bartex00001/The-Keyboard-Project/README.md

# The Keyboard Project  

Documentation can be found here:  
[Notion - The Keyboard Project](https://stefbart.notion.site/The-Keyboard-Project-20efdf3d025f40b1b14f3d861e6cc41f)
