bartex00001/The-Keyboard-Project/Design/Keyboard_layout/23-lines.png

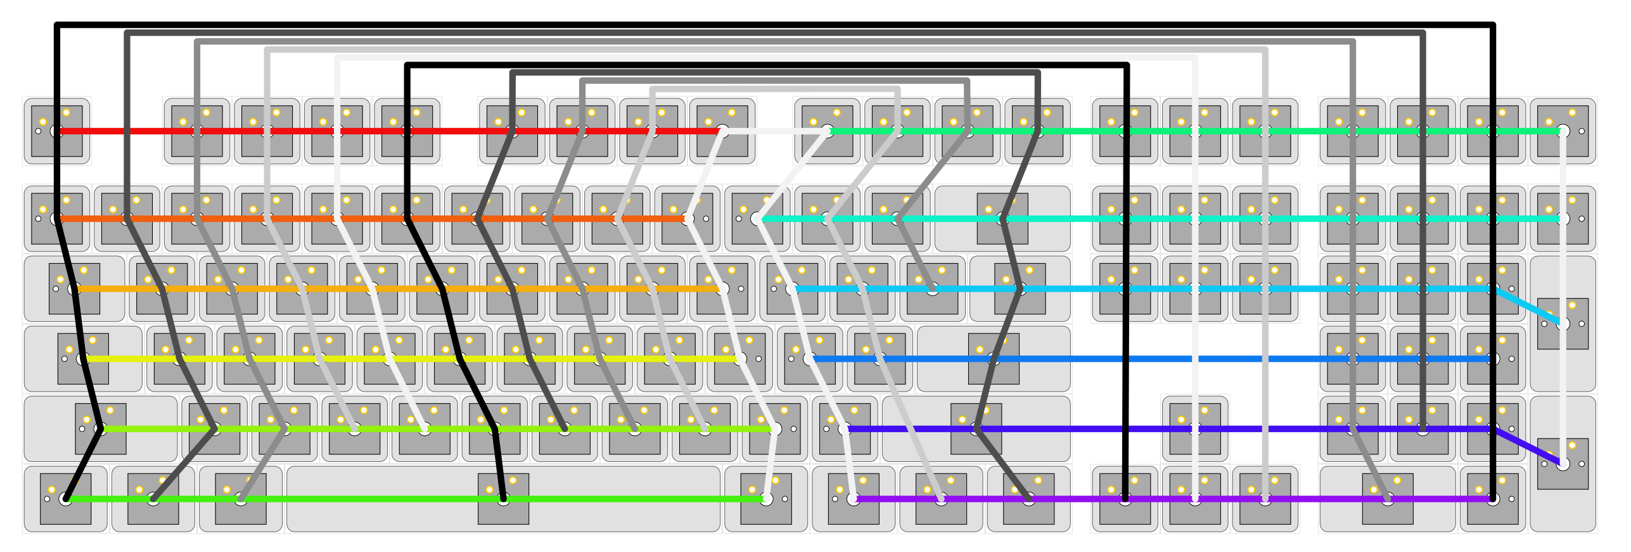
Design/Keyboard_layout/23-lines.png
