bartex00001/The-Keyboard-Project/Design/Keyboard_layout/The keyboard layout.png

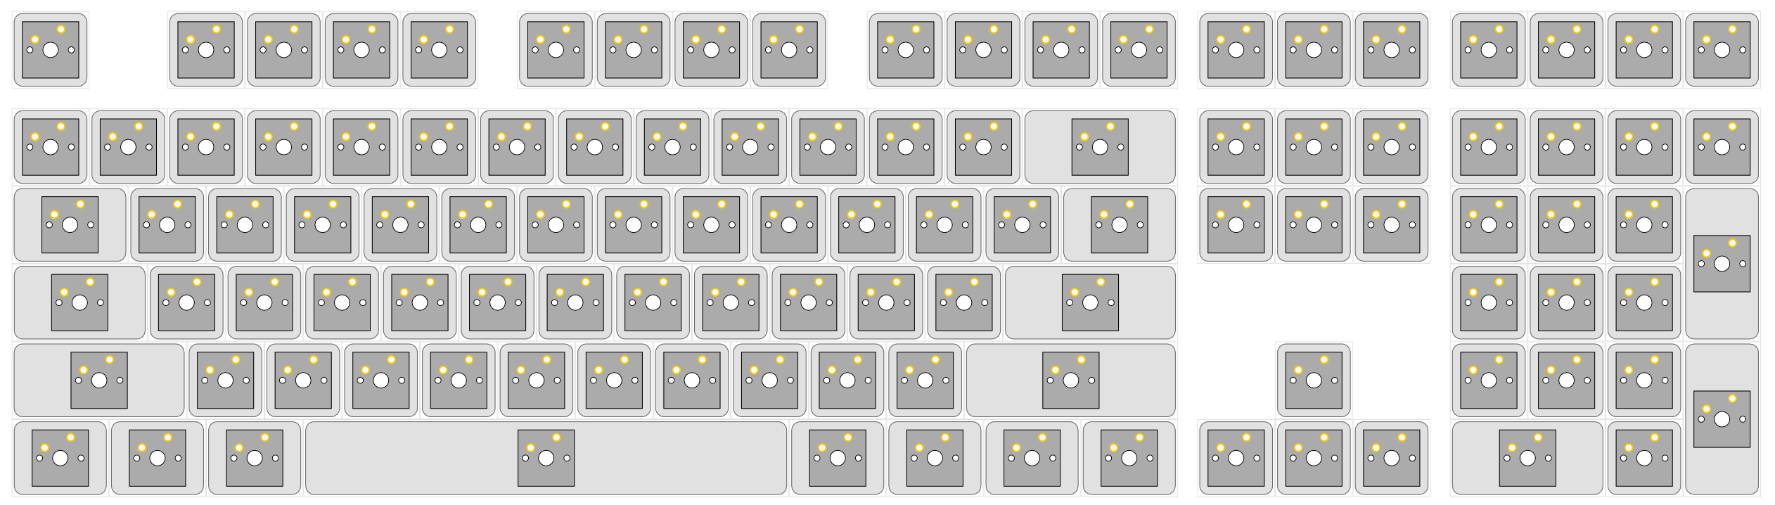
Design/Keyboard_layout/The keyboard layout.png
