bartex00001/The-Keyboard-Project/PCB/main_board/Crystal.png

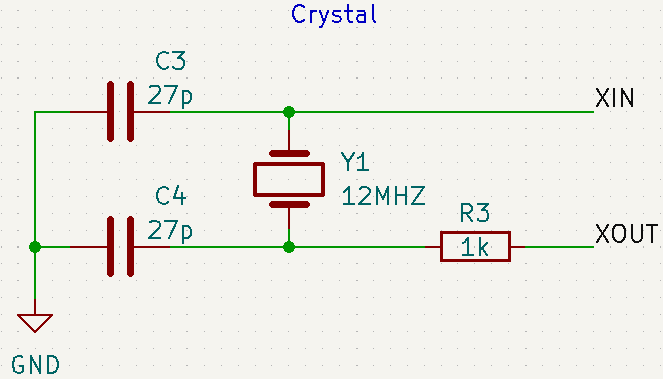
PCB/main_board/Crystal.png
