bartex00001/The-Keyboard-Project/PCB/main_board/Flash memory.png

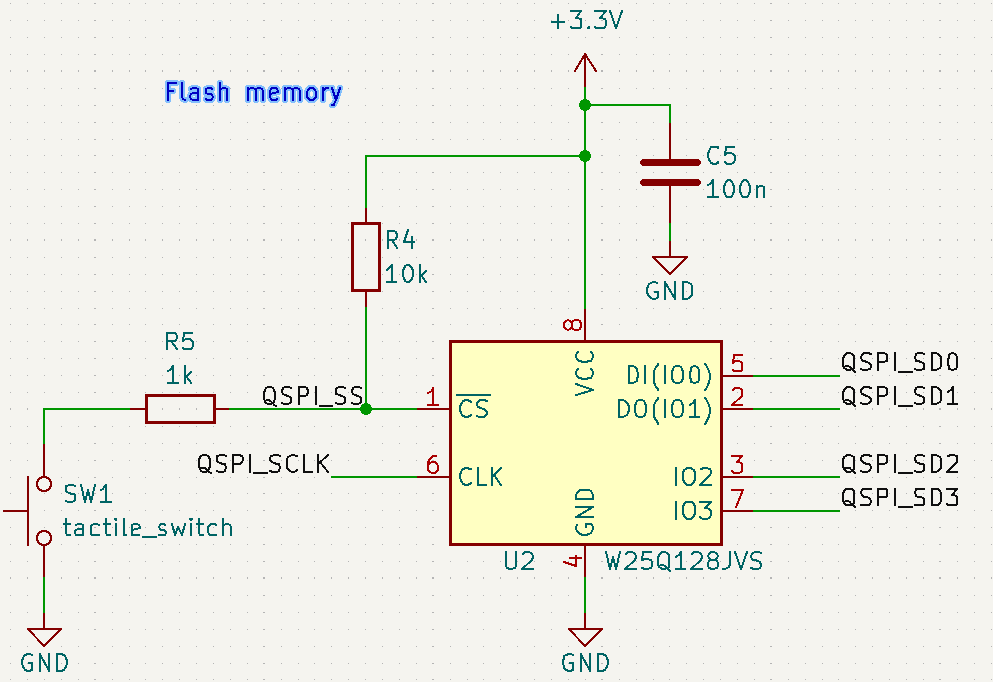
PCB/main_board/Flash memory.png
