bartex00001/The-Keyboard-Project/PCB/main_board/Key matrix.png

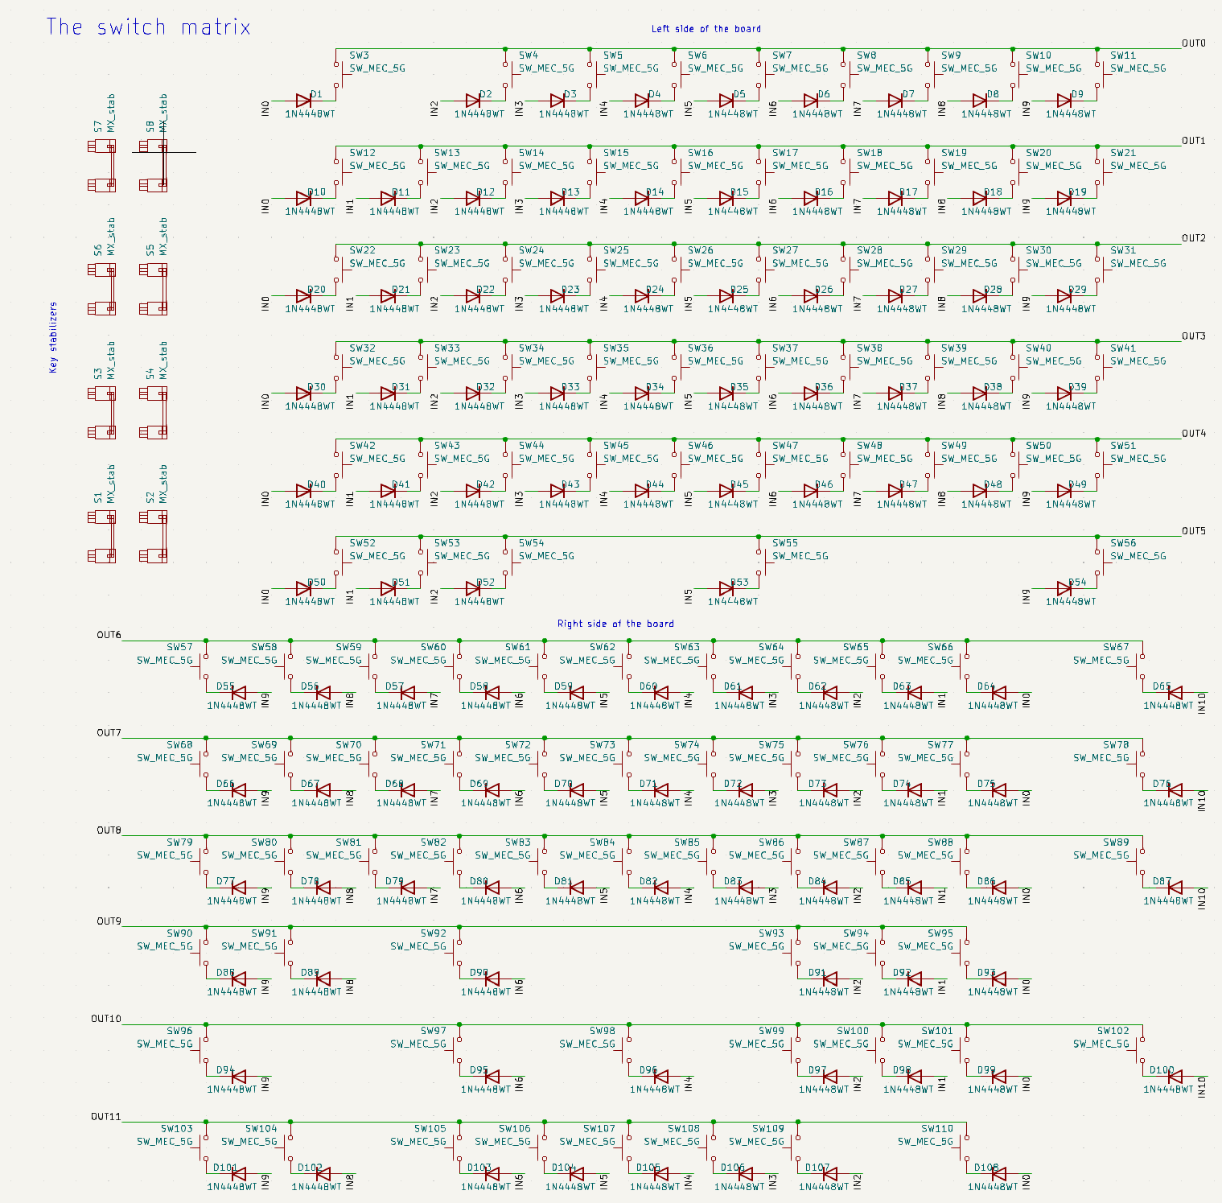
PCB/main_board/Key matrix.png
