bartex00001/The-Keyboard-Project/PCB/main_board/Power supply & usb.png

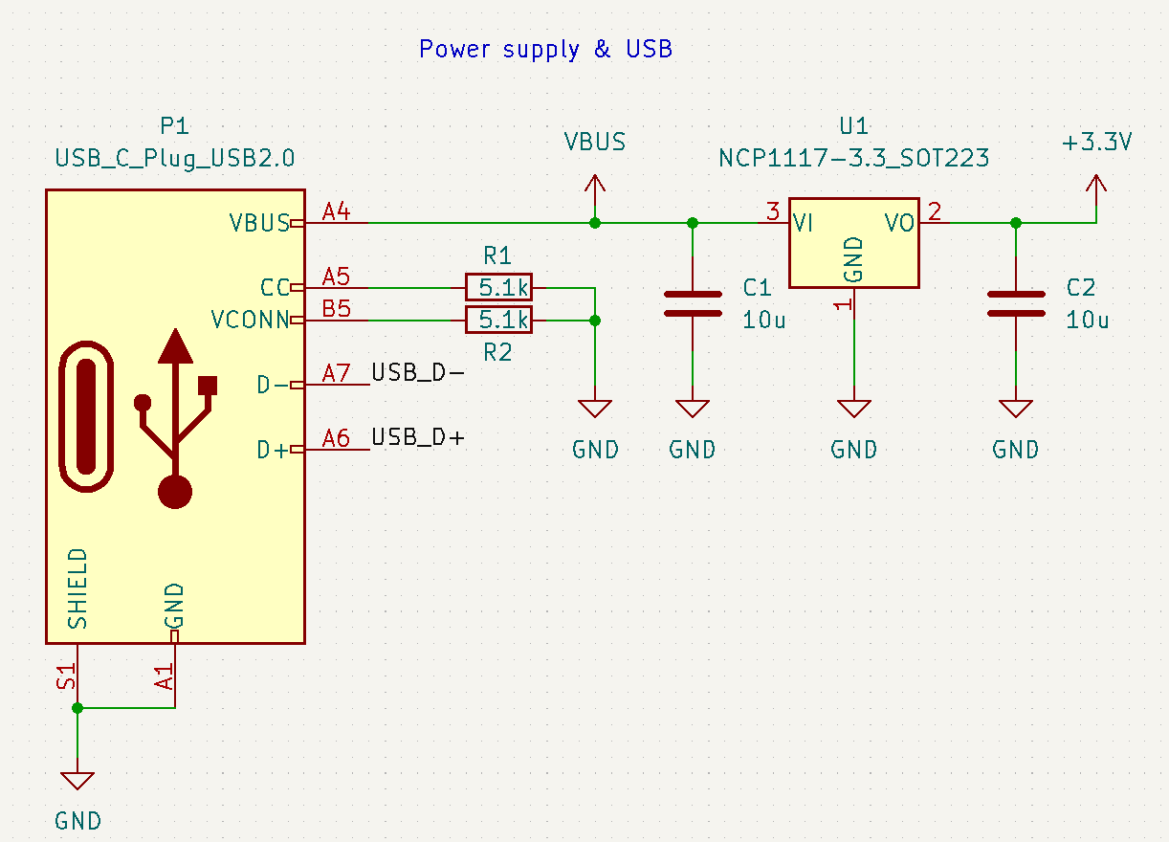
PCB/main_board/Power supply & usb.png
