bartex00001/The-Keyboard-Project/PCB/main_board/RP2040.png

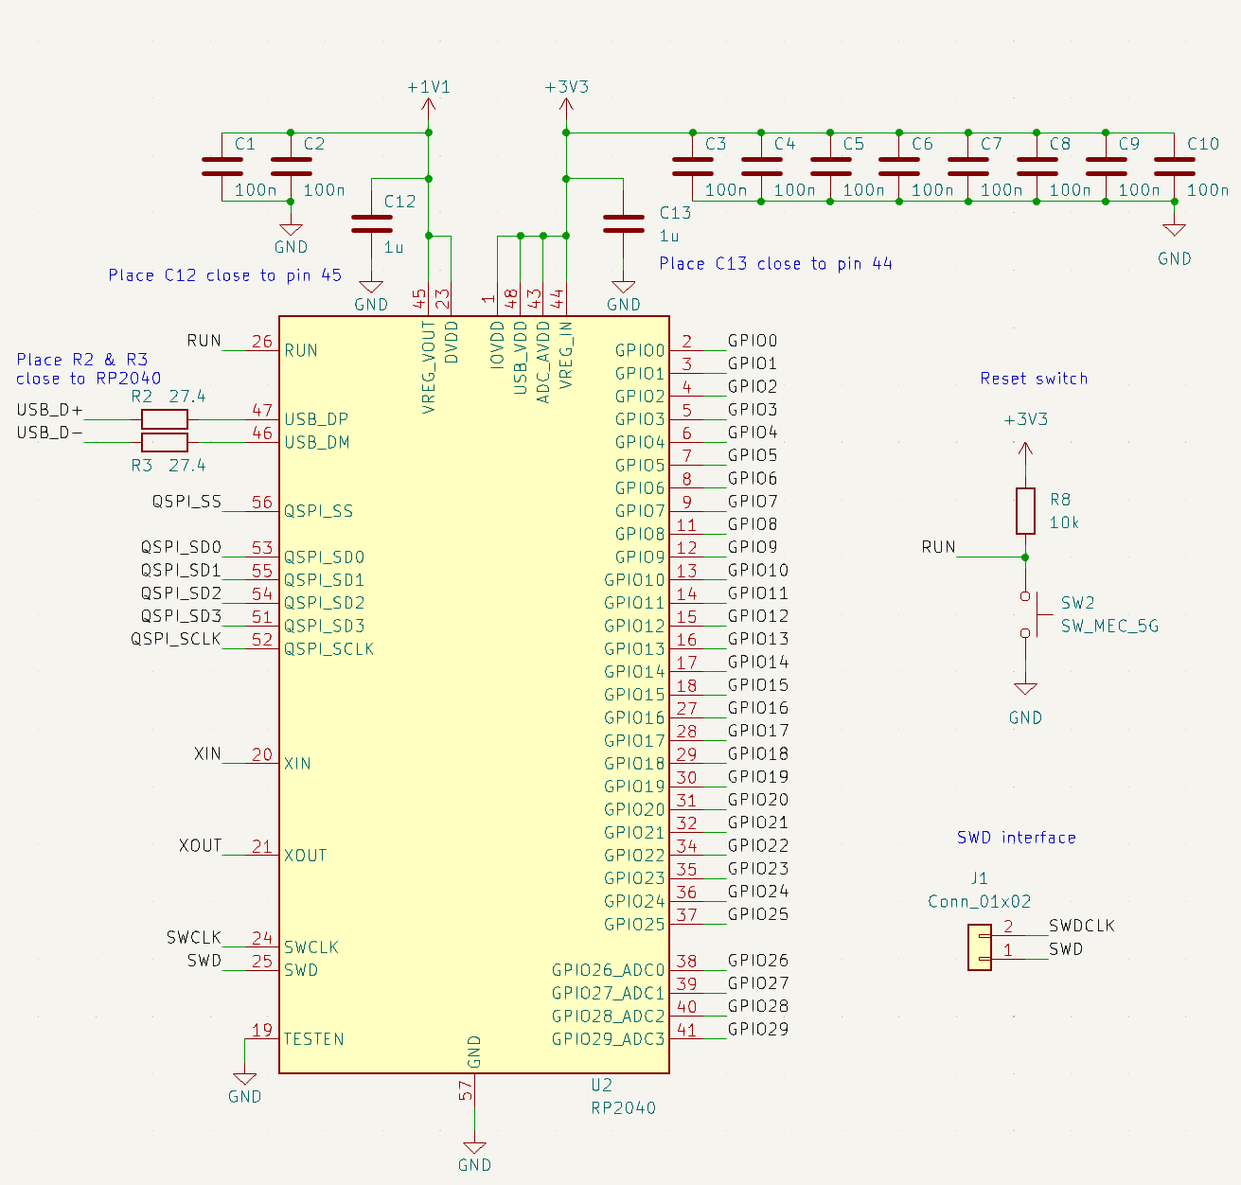
PCB/main_board/RP2040.png
