bartex00001/The-Keyboard-Project/PCB/Switch_matrix/matrix_schematic.png

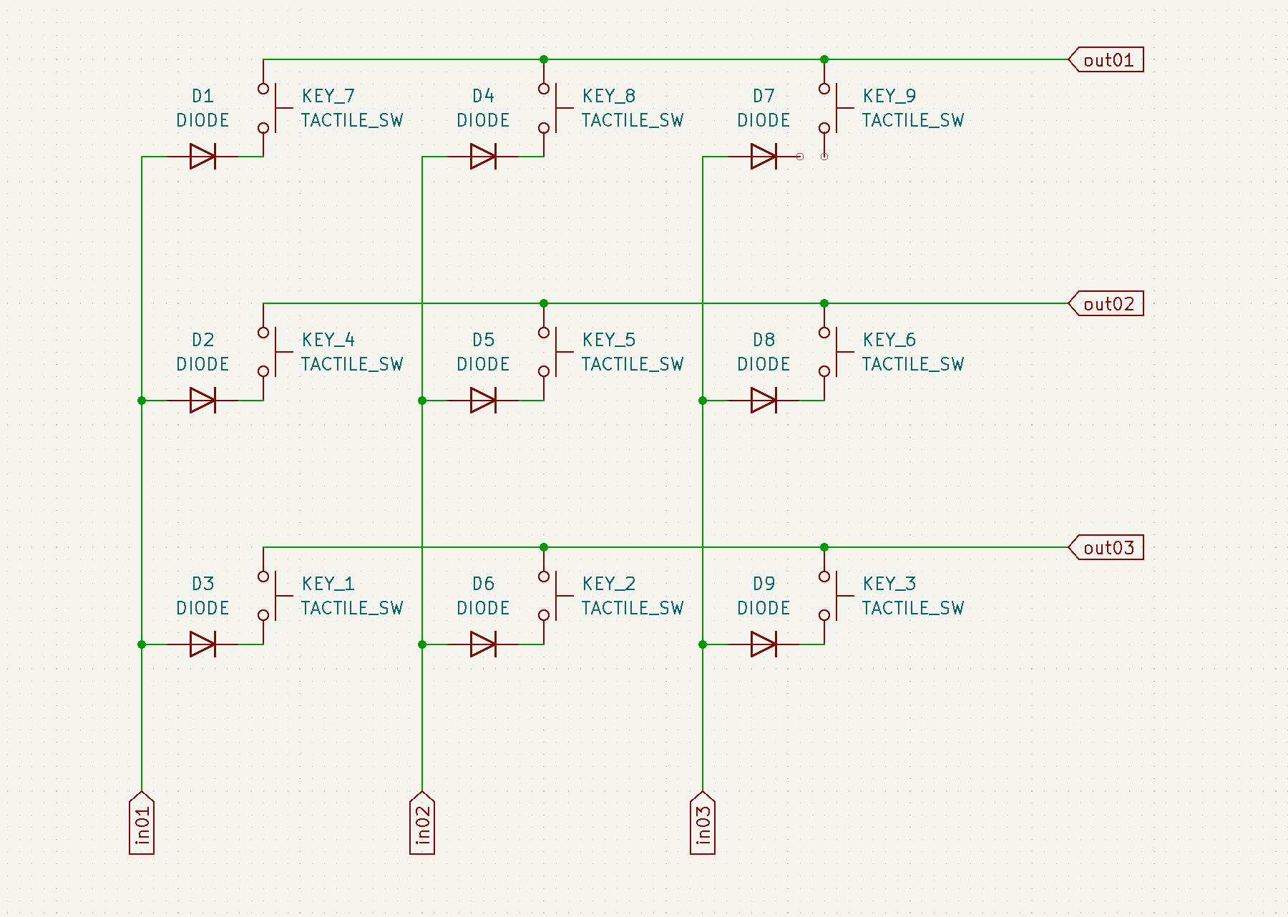
PCB/Switch_matrix/matrix_schematic.png
