bartex00001/The-Keyboard-Project/(threads)

Thread 1 (2022-11-12):

Agree on and write down main project goals

bartex00001, 2022-11-12:
That's basically it, just a list of what we want to do.

bartex00001, 2022-11-29:
# What do we want to create?

A DIY keyboard that we’ll actually use.

## Something like specs I guess

- Full (100%) layout
- USB-C interface
- White backlight — at least *an attempt* will be made
- No hot-swap — expensive and hard to implement
- Programmable keys via user interface
- Key stabilisers for long keys
- No key ghosting

#### Everything as always is available at project’s notion site

Closed 2022-11-29.

Thread 5 (2022-11-20):

Program allowing for reading switch matrix state

bartex00001, 2022-11-20:
Prototype version of the switch matrix will be used for prototyping.
The first thing to do is to read matrix state.
Just that. _(I do not know what I'm doing)_

The bonus objective is to learn C++ and CMAKE for pico

Closed 2023-06-11.

Thread 10 (2022-11-24):

Create a time crystal schematic

bartex00001, 2022-11-24:
The easiest of all circuit designs - just a crystal, capacitor and potentially a resistor.

The crystal should oscillate at 12MHz frequency. See the [documentation](https://datasheets.raspberrypi.com/rp2040/hardware-design-with-rp2040.pdf) for more deatil.

Closed 2023-05-14.

Thread 8 (2022-11-24):

Create a power supply schematic

bartex00001, 2022-11-24:
RP2040 chip requires 3,3 volts, but USB provides 5 thus _something_ that will drop the voltage is necessary.

The most straightforward approach is to use a linear power supply as it's table and reliable.
The only issue are relatively high losses when compared to ex.: buck converter but the solution should suffice as the circuit will require little current.

Note that backlight will probably require separate power supply.

Closed 2023-05-14.

Thread 9 (2022-11-24):

Create a flash storage schematic

bartex00001, 2022-11-24:
External flash is required as RP2040 has no non-volatile memory onboard.

It would be safest to use solution provided by RPI themselves: [Minimal board design](https://datasheets.raspberrypi.com/rp2040/hardware-design-with-rp2040.pdf)

Closed 2023-05-14.

Thread 19 (2023-05-14):

Add RP2040 to the schematic alongside accompanying components

bartex00001, 2023-05-14:
Finally add the microcontroller to the board.
The specification lists some decoupling capacitors and resistors for USB lines so this will be added here as well.

Closed 2023-05-15.

Thread 30 (2023-05-24):

Check KiCad errors and warnings

bartex00001, 2023-05-24:
Some warnings and errors will most likely be raised by KiCad PCB-check.
They need to be looked into to decide what to do with them.

Thread 37 (2023-05-30):

Expose unconnected GPIO pins alongside power rails

bartex00001, 2023-05-30:
## What to expose?
GPIO pins: 8, 9, 10 and 29(adc)
Power rails: 3.3V and 5V (with ground somewhere near both of them)

Closed 2023-05-30.

Thread 39 (2023-05-30):

Add logo and "credits" to silkscreen

bartex00001, 2023-05-30:
The logo will be created in the other issue #33

The "credits" will most likely consist of project title and user names.

bartex00001, 2023-07-03:
Completed in #47

Closed 2023-07-03.

Thread 42 (2023-06-11):

Check weather printed board works as expected (or at all..)

bartex00001, 2023-06-11:
This will be the first _big_ PCB of my design, therefore chance of failure is most likely quite high.
Because of that the first thing to do after receiving the board are a few tests:

- [ ] Hello world - the chip is alive
- [ ] Blink led pin - at least this works
- [ ] Matrix with a few random switches - the connections work (at least some do...)
- [ ] Test reset button - can reset at runtime
- [ ] Overdrive test - the board can supply enough power to the chip

Thread 44 (2023-06-11):

Adapt the driver for printed board

bartex00001, 2023-06-11:
The driver needs to know where the keys are located, thus a definition of key matrix has to be made.
This will mainly involve filling out the `keyMatrix` data and listing `in` and `out` pins.

Thread 48 (2023-07-03):

Add space for mounting holes on the pcb

bartex00001, 2023-07-03:
Some mounting holes are needed to later screw the gasket to pcb.

**Holes will not be drilled** as I do not yet know where they need to be. This is done just to prepare a few places where a screw can go.

Closed 2023-07-03.
