bartex00001/The-Keyboard-Project/PCB/main_board/main_board_schematic/main_board_schematic.kicad_pcb

## KiCad design PCB/main_board/main_board_schematic/main_board_schematic.kicad_pcb (2023-07-03)

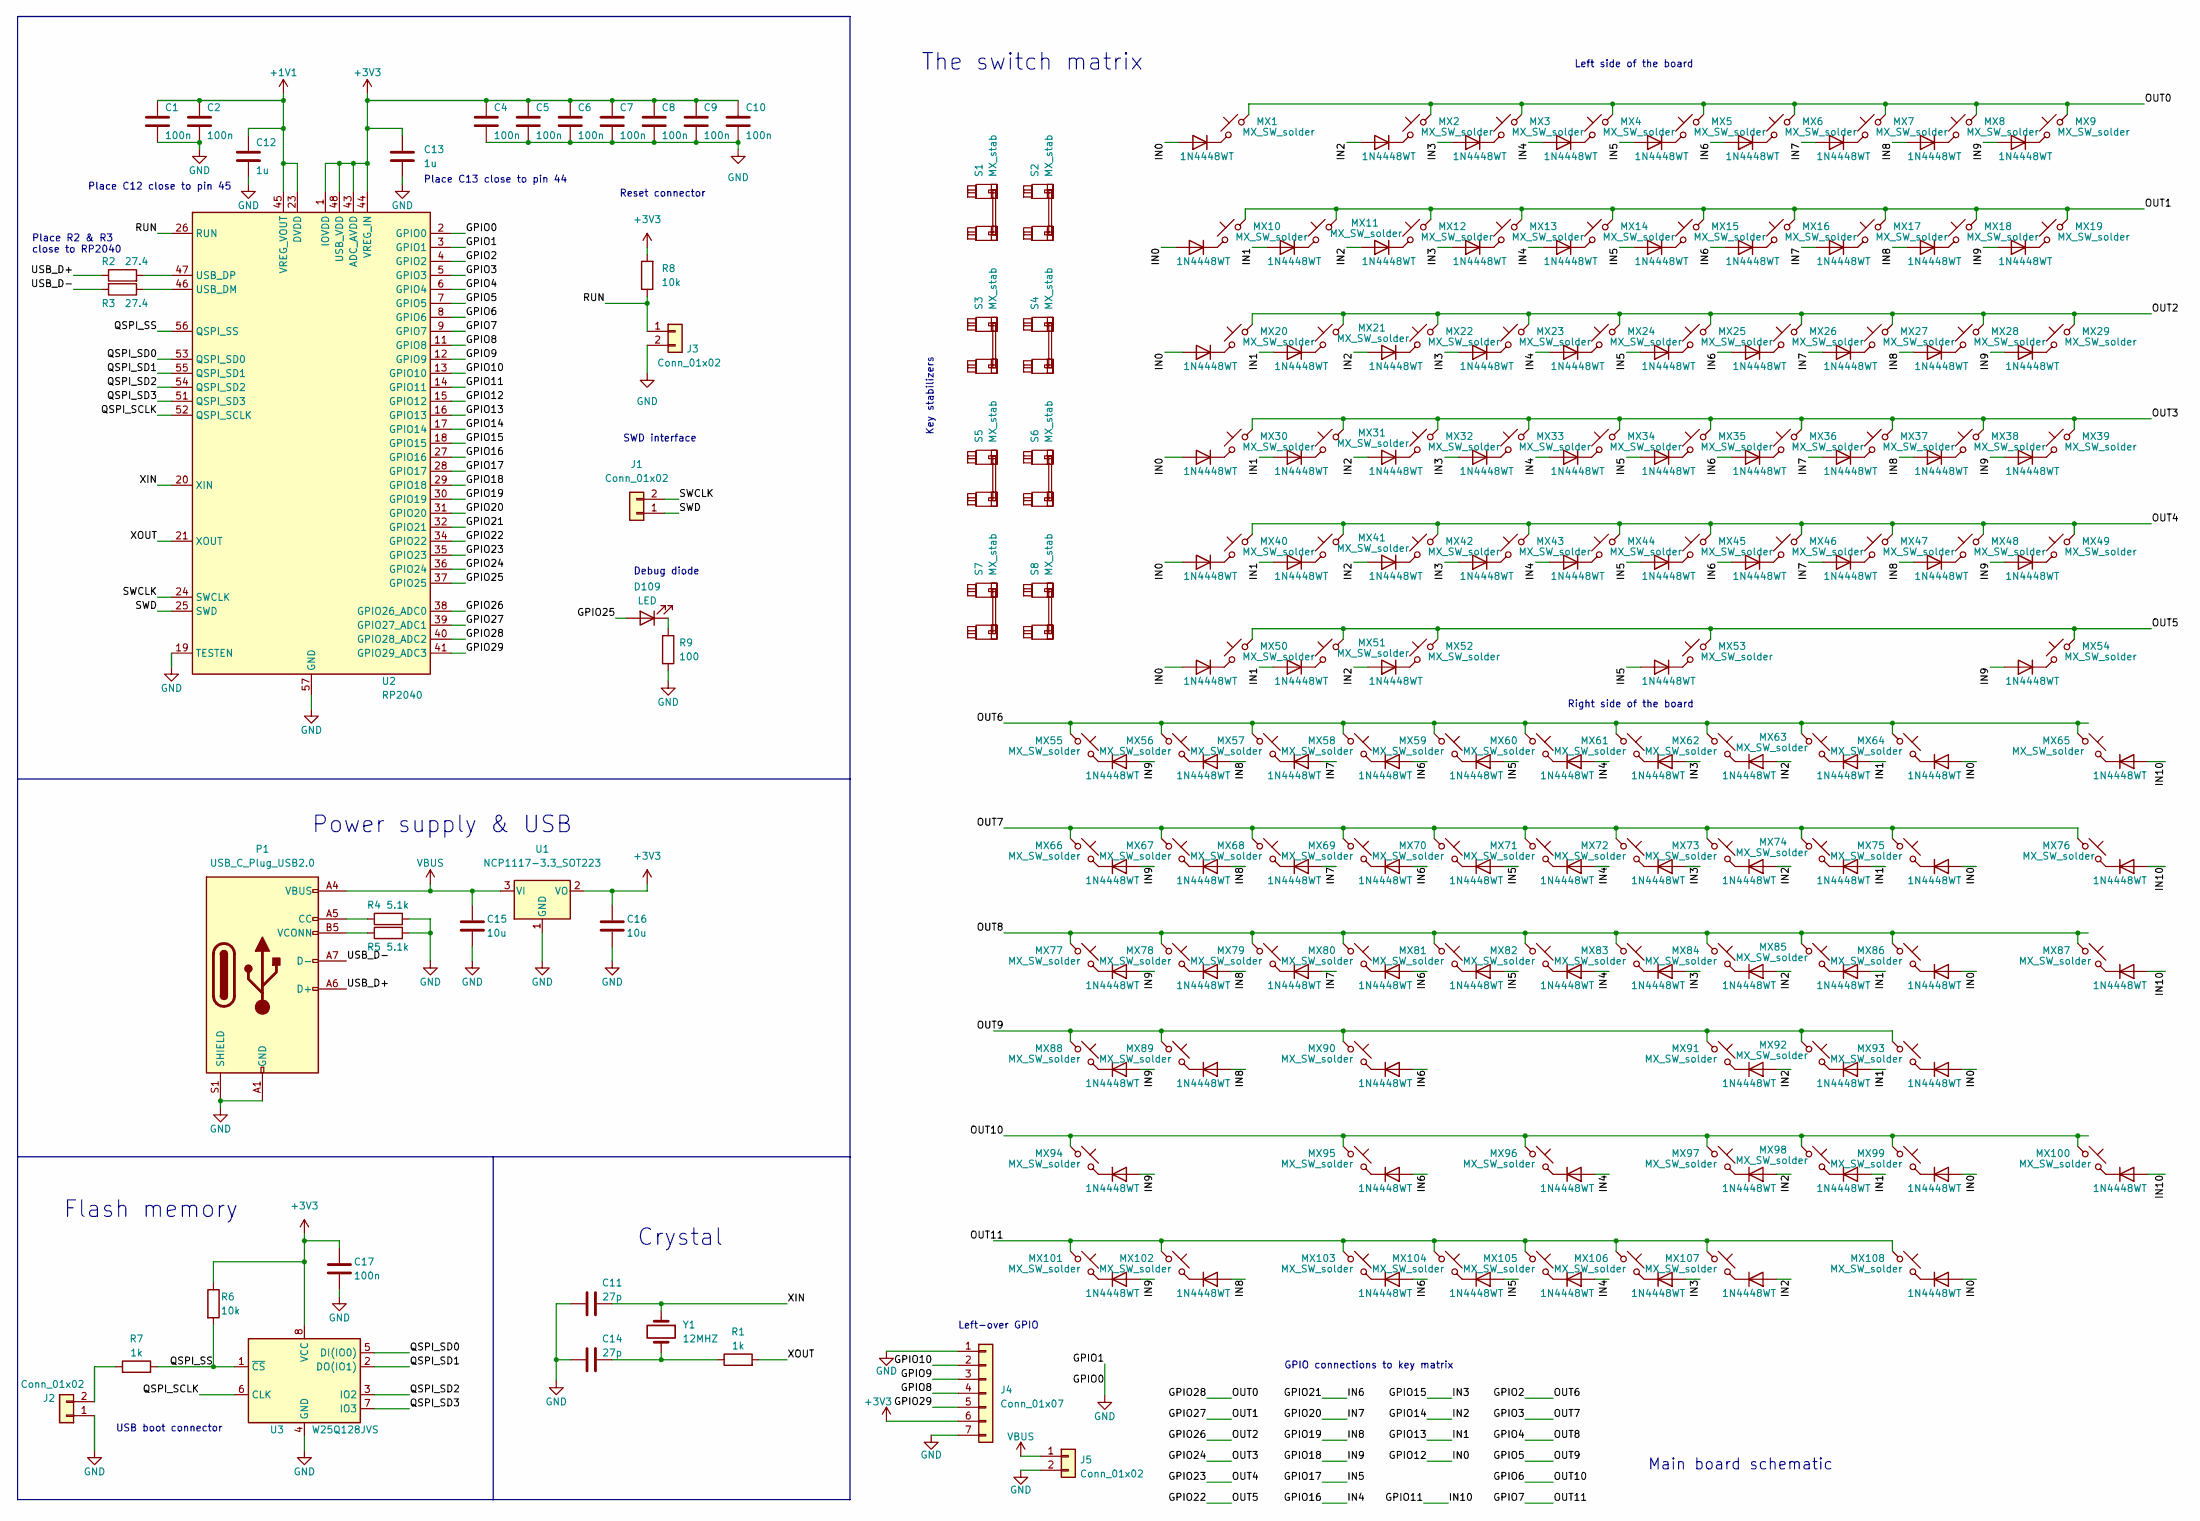
[picture p10: schematic main_board_schematic.kicad_sch]

Parts:
C1, C2, C4, C5, C6, C7, C8, C9, C10, C17: 100n; C_0603_1608Metric
C11, C14: 27p; C_0603_1608Metric
C12, C13: 1u; C_0603_1608Metric
C15, C16: 10u; C_0603_1608Metric
D1, D2, D3, D4, D5, D6, D7, D8, D9, D10, D11, D12, D13, D14, D15, D16, D17, D18, D19, D20, D21, D22, D23, D24, D25, D26, D27, D28, D29, D30, D31, D32, D33, D34, D35, D36, D37, D38, D39, D40, D41, D42, D43, D44, D45, D46, D47, D48, D49, D50, D51, D52, D53, D54, D55, D56, D57, D58, D59, D60, D61, D62, D63, D64, D65, D66, D67, D68, D69, D70, D71, D72, D73, D74, D75, D76, D77, D78, D79, D80, D81, D82, D83, D84, D85, D86, D87, D88, D89, D90, D91, D92, D93, D94, D95, D96, D97, D98, D99, D100, D101, D102, D103, D104, D105, D106, D107, D108: 1N4448WT; D_SOD-523
D109: LED; LED_0603_1608Metric
J1, J2, J3, J5: Conn_01x02; PinHeader_1x02_P2.54mm_Vertical
J4: Conn_01x07; PinHeader_1x07_P2.54mm_Vertical
MX1, MX2, MX3, MX4, MX5, MX6, MX7, MX8, MX9, MX10, MX11, MX12, MX13, MX14, MX15, MX16, MX17, MX18, MX19, MX21, MX22, MX23, MX24, MX25, MX26, MX27, MX28, MX29, MX31, MX32, MX33, MX34, MX35, MX36, MX37, MX38, MX39, MX40, MX41, MX42, MX43, MX44, MX45, MX46, MX47, MX48, MX49, MX53, MX55, MX56, MX57, MX58, MX59, MX60, MX61, MX62, MX63, MX64, MX65, MX66, MX67, MX68, MX69, MX70, MX71, MX72, MX73, MX74, MX75, MX76, MX77, MX78, MX79, MX81, MX82, MX83, MX84, MX85, MX86, MX87, MX88, MX89, MX90, MX91, MX92, MX93, MX94, MX95, MX96, MX97, MX98, MX99, MX100, MX104, MX105, MX106, MX107, MX108: MX_SW_solder; SW_MX_1u
MX20, MX80: MX_SW_solder; SW_MX_1.5u
MX30: MX_SW_solder; SW_MX_1.75u
MX50, MX51, MX52, MX54, MX101, MX102, MX103: MX_SW_solder; SW_MX_1.25u
P1: USB_C_Plug_USB2.0; USB_C_Receptacle_G-Switch_GT-USB-7010ASV
R1, R7: 1k; R_0603_1608Metric
R2, R3: 27.4; R_0603_1608Metric
R4, R5: 5.1k; R_0603_1608Metric
R6, R8: 10k; R_0603_1608Metric
R9: 100; R_0603_1608Metric
S1: MX_stab; STAB_MX_P_6.25u
S2, S5: MX_stab; STAB_MX_P_2.25u
S3, S4, S7, S8: MX_stab; STAB_MX_P_2u
S6: MX_stab; STAB_MX_P_2.75u
U1: NCP1117-3.3_SOT223; SOT-223-3_TabPin2
U2: RP2040; QFN-56-1EP_7x7mm_P0.4mm_EP3.2x3.2mm
U3: W25Q128JVS; SOIC-8_5.23x5.23mm_P1.27mm
Y1: 12MHZ; Crystal_HC49-U_Vertical

Connections:
+1V1: C1.1, C2.1, C12.1, U2.23 (DVDD), U2.45 (VREG_VOUT), U2.50 (DVDD)
+3V3: C4.1, C5.1, C6.1, C7.1, C8.1, C9.1, C10.1, C13.1, C16.1, C17.1, J4.6, R6.1, R8.2, U1.2 (VO), U2.1 (IOVDD), U2.10 (IOVDD), U2.22 (IOVDD), U2.33 (IOVDD), U2.42 (IOVDD), U2.43 (ADC_AVDD), U2.44 (VREG_IN), U2.48 (USB_VDD), U2.49 (IOVDD), U3.8 (VCC)
/GPIO2: MX55.2, MX56.2, MX57.2, MX58.2, MX59.2, MX60.2, MX61.2, MX62.2, MX63.2, MX64.2, MX65.2, U2.4 (GPIO2)
/GPIO3: MX66.2, MX67.2, MX68.2, MX69.2, MX70.2, MX71.2, MX72.2, MX73.2, MX74.2, MX75.2, MX76.2, U2.5 (GPIO3)
/GPIO4: MX77.2, MX78.2, MX79.2, MX80.2, MX81.2, MX82.2, MX83.2, MX84.2, MX85.2, MX86.2, MX87.2, U2.6 (GPIO4)
/GPIO5: MX88.2, MX89.2, MX90.2, MX91.2, MX92.2, MX93.2, U2.7 (GPIO5)
/GPIO6: MX94.2, MX95.2, MX96.2, MX97.2, MX98.2, MX99.2, MX100.2, U2.8 (GPIO6)
/GPIO7: MX101.2, MX102.2, MX103.2, MX104.2, MX105.2, MX106.2, MX107.2, MX108.2, U2.9 (GPIO7)
/GPIO8: J4.4, U2.11 (GPIO8)
/GPIO9: J4.3, U2.12 (GPIO9)
/GPIO10: J4.2, U2.13 (GPIO10)
/GPIO11: D65.2 (A), D76.2 (A), D87.2 (A), D100.2 (A), U2.14 (GPIO11)
/GPIO12: D1.2 (A), D10.2 (A), D20.2 (A), D30.2 (A), D40.2 (A), D50.2 (A), D64.2 (A), D75.2 (A), D86.2 (A), D93.2 (A), D99.2 (A), D108.2 (A), U2.15 (GPIO12)
/GPIO13: D11.2 (A), D21.2 (A), D31.2 (A), D41.2 (A), D51.2 (A), D63.2 (A), D74.2 (A), D85.2 (A), D92.2 (A), D98.2 (A), U2.16 (GPIO13)
/GPIO14: D2.2 (A), D12.2 (A), D22.2 (A), D32.2 (A), D42.2 (A), D52.2 (A), D62.2 (A), D73.2 (A), D84.2 (A), D91.2 (A), D97.2 (A), D107.2 (A), U2.17 (GPIO14)
/GPIO15: D3.2 (A), D13.2 (A), D23.2 (A), D33.2 (A), D43.2 (A), D61.2 (A), D72.2 (A), D83.2 (A), D106.2 (A), U2.18 (GPIO15)
/GPIO16: D4.2 (A), D14.2 (A), D24.2 (A), D34.2 (A), D44.2 (A), D60.2 (A), D71.2 (A), D82.2 (A), D96.2 (A), D105.2 (A), U2.27 (GPIO16)
/GPIO17: D5.2 (A), D15.2 (A), D25.2 (A), D35.2 (A), D45.2 (A), D53.2 (A), D59.2 (A), D70.2 (A), D81.2 (A), D104.2 (A), U2.28 (GPIO17)
/GPIO18: D9.2 (A), D19.2 (A), D29.2 (A), D39.2 (A), D49.2 (A), D54.2 (A), D55.2 (A), D66.2 (A), D77.2 (A), D88.2 (A), D94.2 (A), D101.2 (A), U2.29 (GPIO18)
/GPIO19: D8.2 (A), D18.2 (A), D28.2 (A), D38.2 (A), D48.2 (A), D56.2 (A), D67.2 (A), D78.2 (A), D89.2 (A), D102.2 (A), U2.30 (GPIO19)
/GPIO20: D7.2 (A), D17.2 (A), D27.2 (A), D37.2 (A), D47.2 (A), D57.2 (A), D68.2 (A), D79.2 (A), U2.31 (GPIO20)
/GPIO21: D6.2 (A), D16.2 (A), D26.2 (A), D36.2 (A), D46.2 (A), D58.2 (A), D69.2 (A), D80.2 (A), D90.2 (A), D95.2 (A), D103.2 (A), U2.32 (GPIO21)
/GPIO22: MX50.2, MX51.2, MX52.2, MX53.2, MX54.2, U2.34 (GPIO22)
/GPIO23: MX40.2, MX41.2, MX42.2, MX43.2, MX44.2, MX45.2, MX46.2, MX47.2, MX48.2, MX49.2, U2.35 (GPIO23)
/GPIO24: MX30.2, MX31.2, MX32.2, MX33.2, MX34.2, MX35.2, MX36.2, MX37.2, MX38.2, MX39.2, U2.36 (GPIO24)
/GPIO25: D109.2 (A), U2.37 (GPIO25)
/GPIO26: MX20.2, MX21.2, MX22.2, MX23.2, MX24.2, MX25.2, MX26.2, MX27.2, MX28.2, MX29.2, U2.38 (GPIO26_ADC0)
/GPIO27: MX10.2, MX11.2, MX12.2, MX13.2, MX14.2, MX15.2, MX16.2, MX17.2, MX18.2, MX19.2, U2.39 (GPIO27_ADC1)
/GPIO28: MX1.2, MX2.2, MX3.2, MX4.2, MX5.2, MX6.2, MX7.2, MX8.2, MX9.2, U2.40 (GPIO28_ADC2)
/GPIO29: J4.5, U2.41 (GPIO29_ADC3)
/QSPI_SCLK: U2.52 (QSPI_SCLK), U3.6 (CLK)
/QSPI_SD0: U2.53 (QSPI_SD0), U3.5 (DI(IO0))
/QSPI_SD1: U2.55 (QSPI_SD1), U3.2 (DO(IO1))
/QSPI_SD2: U2.54 (QSPI_SD2), U3.3 (IO2)
/QSPI_SD3: U2.51 (QSPI_SD3), U3.7 (IO3)
/QSPI_SS: R6.2, R7.2, U2.56 (QSPI_SS), U3.1 (~CS)
/RUN: J3.1, R8.1, U2.26 (RUN)
/SWCLK: J1.2, U2.24 (SWCLK)
/SWD: J1.1, U2.25 (SWD)
/USB_D+: P1.A6 (D+), R2.1
/USB_D-: P1.A7 (D-), R3.2
/XIN: C11.1, U2.20 (XIN), Y1.1
/XOUT: R1.2, U2.21 (XOUT)
GND: C1.2, C2.2, C4.2, C5.2, C6.2, C7.2, C8.2, C9.2, C10.2, C11.2, C12.2, C13.2, C14.1, C15.2, C16.2, C17.2, J2.1, J3.2, J4.1, J4.7, J5.2, P1.A1 (GND), P1.A12 (GND), P1.B1 (GND), P1.B12 (GND), P1.S1 (SHIELD), R4.2, R5.2, R9.2, U1.1 (GND), U2.2 (GPIO0), U2.3 (GPIO1), U2.19 (TESTEN), U2.57 (GND), U3.4 (GND)
unnamed: C14.2, R1.1, Y1.2
unnamed: D1.1 (K), MX1.1
unnamed: D2.1 (K), MX2.1
unnamed: D3.1 (K), MX3.1
unnamed: D4.1 (K), MX4.1
unnamed: D5.1 (K), MX5.1
unnamed: D6.1 (K), MX6.1
unnamed: D7.1 (K), MX7.1
unnamed: D8.1 (K), MX8.1
unnamed: D9.1 (K), MX9.1
unnamed: D10.1 (K), MX10.1
unnamed: D11.1 (K), MX11.1
unnamed: D12.1 (K), MX12.1
unnamed: D13.1 (K), MX13.1
unnamed: D14.1 (K), MX14.1
unnamed: D15.1 (K), MX15.1
unnamed: D16.1 (K), MX16.1
unnamed: D17.1 (K), MX17.1
unnamed: D18.1 (K), MX18.1
unnamed: D19.1 (K), MX19.1
unnamed: D20.1 (K), MX20.1
unnamed: D21.1 (K), MX21.1
unnamed: D22.1 (K), MX22.1
unnamed: D23.1 (K), MX23.1
unnamed: D24.1 (K), MX24.1
unnamed: D25.1 (K), MX25.1
unnamed: D26.1 (K), MX26.1
unnamed: D27.1 (K), MX27.1
unnamed: D28.1 (K), MX28.1
unnamed: D29.1 (K), MX29.1
unnamed: D30.1 (K), MX30.1
unnamed: D31.1 (K), MX31.1
unnamed: D32.1 (K), MX32.1
unnamed: D33.1 (K), MX33.1
unnamed: D34.1 (K), MX34.1
unnamed: D35.1 (K), MX35.1
unnamed: D36.1 (K), MX36.1
unnamed: D37.1 (K), MX37.1
unnamed: D38.1 (K), MX38.1
unnamed: D39.1 (K), MX39.1
unnamed: D40.1 (K), MX40.1
unnamed: D41.1 (K), MX41.1
unnamed: D42.1 (K), MX42.1
unnamed: D43.1 (K), MX43.1
unnamed: D44.1 (K), MX44.1
unnamed: D45.1 (K), MX45.1
unnamed: D46.1 (K), MX46.1
unnamed: D47.1 (K), MX47.1
unnamed: D48.1 (K), MX48.1
unnamed: D49.1 (K), MX49.1
unnamed: D50.1 (K), MX50.1
unnamed: D51.1 (K), MX51.1
unnamed: D52.1 (K), MX52.1
unnamed: D53.1 (K), MX53.1
unnamed: D54.1 (K), MX54.1
unnamed: D55.1 (K), MX55.1
unnamed: D56.1 (K), MX56.1
unnamed: D57.1 (K), MX57.1
unnamed: D58.1 (K), MX58.1
unnamed: D59.1 (K), MX59.1
unnamed: D60.1 (K), MX60.1
unnamed: D61.1 (K), MX61.1
unnamed: D62.1 (K), MX62.1
unnamed: D63.1 (K), MX63.1
unnamed: D64.1 (K), MX64.1
unnamed: D65.1 (K), MX65.1
unnamed: D66.1 (K), MX66.1
unnamed: D67.1 (K), MX67.1
unnamed: D68.1 (K), MX68.1
unnamed: D69.1 (K), MX69.1
unnamed: D70.1 (K), MX70.1
unnamed: D71.1 (K), MX71.1
unnamed: D72.1 (K), MX72.1
unnamed: D73.1 (K), MX73.1
unnamed: D74.1 (K), MX74.1
unnamed: D75.1 (K), MX75.1
unnamed: D76.1 (K), MX76.1
unnamed: D77.1 (K), MX77.1
unnamed: D78.1 (K), MX78.1
unnamed: D79.1 (K), MX79.1
unnamed: D80.1 (K), MX80.1
unnamed: D81.1 (K), MX81.1
unnamed: D82.1 (K), MX82.1
unnamed: D83.1 (K), MX83.1
unnamed: D84.1 (K), MX84.1
unnamed: D85.1 (K), MX85.1
unnamed: D86.1 (K), MX86.1
unnamed: D87.1 (K), MX87.1
unnamed: D88.1 (K), MX88.1
unnamed: D89.1 (K), MX89.1
unnamed: D90.1 (K), MX90.1
unnamed: D91.1 (K), MX91.1
unnamed: D92.1 (K), MX92.1
unnamed: D93.1 (K), MX93.1
unnamed: D94.1 (K), MX94.1
unnamed: D95.1 (K), MX95.1
unnamed: D96.1 (K), MX96.1
unnamed: D97.1 (K), MX97.1
unnamed: D98.1 (K), MX98.1
unnamed: D99.1 (K), MX99.1
unnamed: D100.1 (K), MX100.1
unnamed: D101.1 (K), MX101.1
unnamed: D102.1 (K), MX102.1
unnamed: D103.1 (K), MX103.1
unnamed: D104.1 (K), MX104.1
unnamed: D105.1 (K), MX105.1
unnamed: D106.1 (K), MX106.1
unnamed: D107.1 (K), MX107.1
unnamed: D108.1 (K), MX108.1
unnamed: D109.1 (K), R9.1
unnamed: J2.2, R7.1
unnamed: P1.A5 (CC), R4.1
unnamed: P1.B5 (VCONN), R5.1
unnamed: R3.1, U2.46 (USB_DM)
unnamed: R2.2, U2.47 (USB_DP)
VBUS: C15.1, J5.1, P1.A4 (VBUS), P1.A9 (VBUS), P1.B4 (VBUS), P1.B9 (VBUS), U1.3 (VI)

Notes on the sheet:
Debug diode
USB boot connector
Crystal
Right side of the board
Key stabilizers
Place R2 & R3 close to RP2040
Place C13 close to pin 44
Place C12 close to pin 45
Main board schematic
Left side of the board
GPIO connections to key matrix
Reset connector
SWD interface
Left-over GPIO
Flash memory
The switch matrix
Power supply & USB

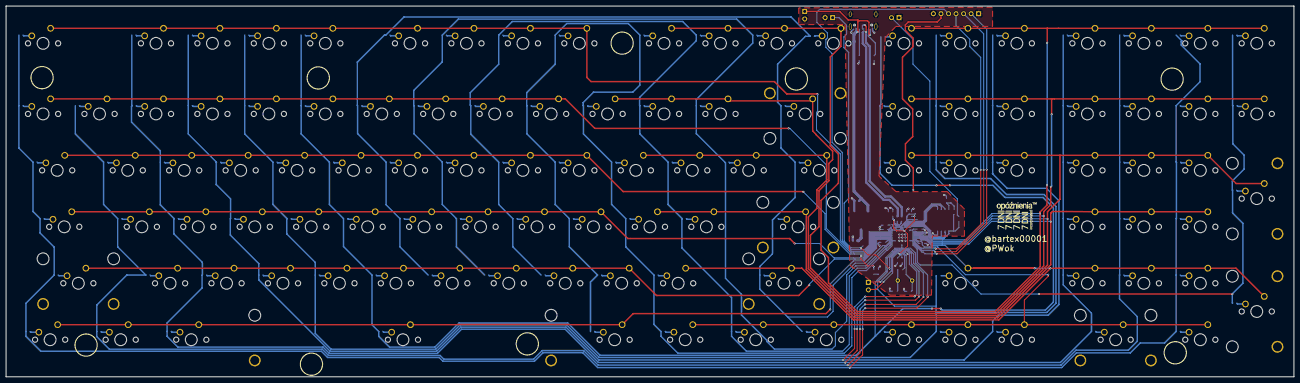
[picture p11: board main_board_schematic.kicad_pcb from above]

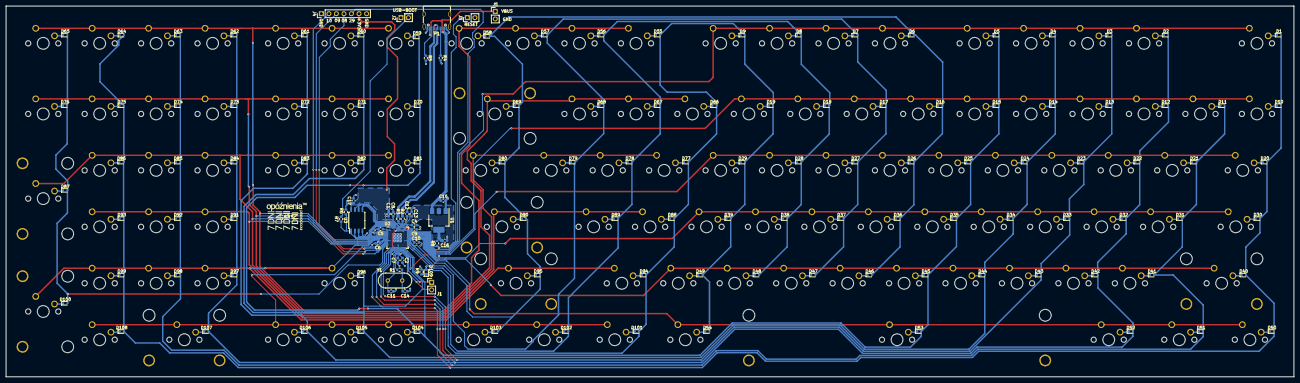
[picture p12: board main_board_schematic.kicad_pcb from below]

Board: 2 copper layers, 434.6 x 125.1 mm, 260 parts (144 on the bottom side), 160 nets.
