bartex00001/The-Keyboard-Project/PCB/Switch_matrix/switch_matrix_schematic/switch_matrix.kicad_sch

## KiCad design PCB/Switch_matrix/switch_matrix_schematic/switch_matrix.kicad_sch (2023-05-06)

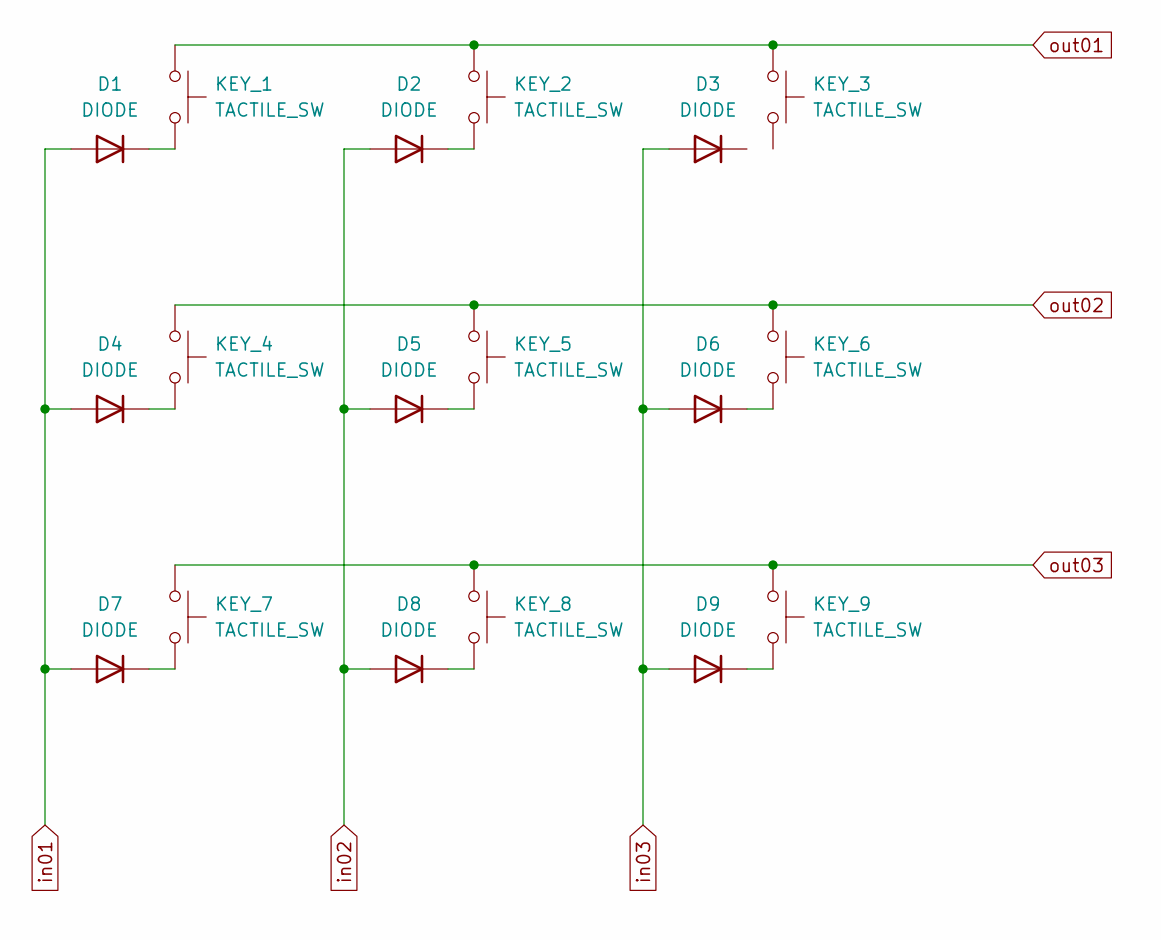
[picture p13: schematic switch_matrix.kicad_sch]

Parts:
D1, D2, D3, D4, D5, D6, D7, D8, D9: DIODE
KEY_1, KEY_2, KEY_3, KEY_4, KEY_5, KEY_6, KEY_7, KEY_8, KEY_9: TACTILE_SW

Connections:
unnamed: D1.2 (K), KEY_1.3 (B), KEY_1.4 (B)
unnamed: D2.2 (K), KEY_2.3 (B), KEY_2.4 (B)
unnamed: D4.2 (K), KEY_4.3 (B), KEY_4.4 (B)
unnamed: D5.2 (K), KEY_5.3 (B), KEY_5.4 (B)
unnamed: D6.2 (K), KEY_6.3 (B), KEY_6.4 (B)
unnamed: D7.2 (K), KEY_7.3 (B), KEY_7.4 (B)
unnamed: D8.2 (K), KEY_8.3 (B), KEY_8.4 (B)
unnamed: D9.2 (K), KEY_9.3 (B), KEY_9.4 (B)
unnamed: KEY_3.3 (B), KEY_3.4 (B)
in01: D1.1 (A), D4.1 (A), D7.1 (A)
in02: D2.1 (A), D5.1 (A), D8.1 (A)
in03: D3.1 (A), D6.1 (A), D9.1 (A)
out01: KEY_1.1 (A), KEY_1.2 (A), KEY_2.1 (A), KEY_2.2 (A), KEY_3.1 (A), KEY_3.2 (A)
out02: KEY_4.1 (A), KEY_4.2 (A), KEY_5.1 (A), KEY_5.2 (A), KEY_6.1 (A), KEY_6.2 (A)
out03: KEY_7.1 (A), KEY_7.2 (A), KEY_8.1 (A), KEY_8.2 (A), KEY_9.1 (A), KEY_9.2 (A)
