bartex00001/The-Keyboard-Project/(commit log)

2022-11-20 Created a schematic for a switch matrix
    [switch_matrix.csv, switch_matrix.kicad_pcb, switch_matrix.kicad_sch]
2022-11-20 Image of built prototype switch matrix
2022-11-27 Added a readme to Keyboard Driver
2023-05-06 Prototype now better represents the schematic
2023-05-06 Renamed schematic components
    [switch_matrix.kicad_sch]
2023-05-11 Created new kiCad project for the board and added basic components for power supply
    [main_board_schematic.kicad_pcb, main_board_schematic.kicad_sch]
2023-05-12 Added pull downs for cc and vconn
    [main_board_schematic.kicad_sch]
2023-05-12 Fixed wiring mistake...
    [main_board_schematic.kicad_sch]
2023-05-13 Turned of uart support
2023-05-14 Added label for power supply and usb
    [main_board_schematic.kicad_sch]
2023-05-14 Created the crystal oscilator
    [main_board_schematic.kicad_sch]
2023-05-14 Project organisation - added photos of circuit sections and a title
    [main_board_schematic.kicad_sch]
2023-05-14 Created a schematic for the flash storage
    [main_board_schematic.kicad_sch]
2023-05-14 Moved the components around 'minor changes'
    [main_board_schematic.kicad_sch]
2023-05-15 Added rp2040 alongside some components
    [main_board_schematic.kicad_sch]
2023-05-16 Added all the siwtches to the board
    [main_board_schematic.kicad_sch]
2023-05-16 Moved to kicad7 and added key stabilizers
    [main_board_schematic.kicad_sch]
2023-05-16 Added images of rp2040 and switch matrix
2023-05-16 Added labels to the stabilizers
    [main_board_schematic.kicad_sch]
2023-05-17 Added footprints for all components
    [main_board_schematic.kicad_sch]
2023-05-17 Chenged the chematic switches to mx-switches
    [main_board_schematic.kicad_pcb, main_board_schematic.kicad_sch]
2023-05-20 Placed large portion of the diodes
    [main_board_schematic.kicad_pcb, main_board_schematic.kicad_sch]
2023-05-21 Added all diodes to key matrix
    [main_board_schematic.kicad_pcb]
2023-05-21 placed the rp2040 inside the board
    [main_board_schematic.kicad_pcb, main_board_schematic.kicad_sch]
2023-05-24 Placed and connected all components
    [main_board_schematic.kicad_pcb, main_board_schematic.kicad_sch]
2023-05-25 Connected matrix to the rp2040
    [main_board_schematic.kicad_pcb, main_board_schematic.kicad_sch]
2023-05-30 Moved usb-c connector and added labels
    [main_board_schematic.kicad_pcb, main_board_schematic.kicad_sch]
2023-05-30 Added a led connected to pin25
    [main_board_schematic.kicad_pcb, main_board_schematic.kicad_sch]
2023-05-30 Exposed pins and power rails
    [main_board_schematic.kicad_pcb, main_board_schematic.kicad_sch]
2023-05-30 Created logo with transparent background and a kicad lib file
2023-05-30 Fixed footprints for pins
    [main_board_schematic.kicad_pcb, main_board_schematic.kicad_sch]
2023-06-07 New CMake structure for keyboard driver
2023-07-03 Placed text and 7DL logo on pcb
    [main_board_schematic.kicad_pcb]
2023-07-03 Added logo to the back side of pcb
    [main_board_schematic.kicad_pcb]
2023-07-03 Added silcscreen guide to where holes can be drilled
    [main_board_schematic.kicad_pcb]
